2ahunter/POCO_interface/(commit log)

2025-02-19 Completed PCB layout
    [POCO_interface.kicad_pcb, POCO_interface.kicad_sch]
2025-02-20 Removed ground connection to IDC mounting pads
    [POCO_interface.kicad_pcb]
